findersee/RP2040-MQTT-Controller/README.md

# Controller
<p>RP2040 MQTT Controller for DIN Rail</p>
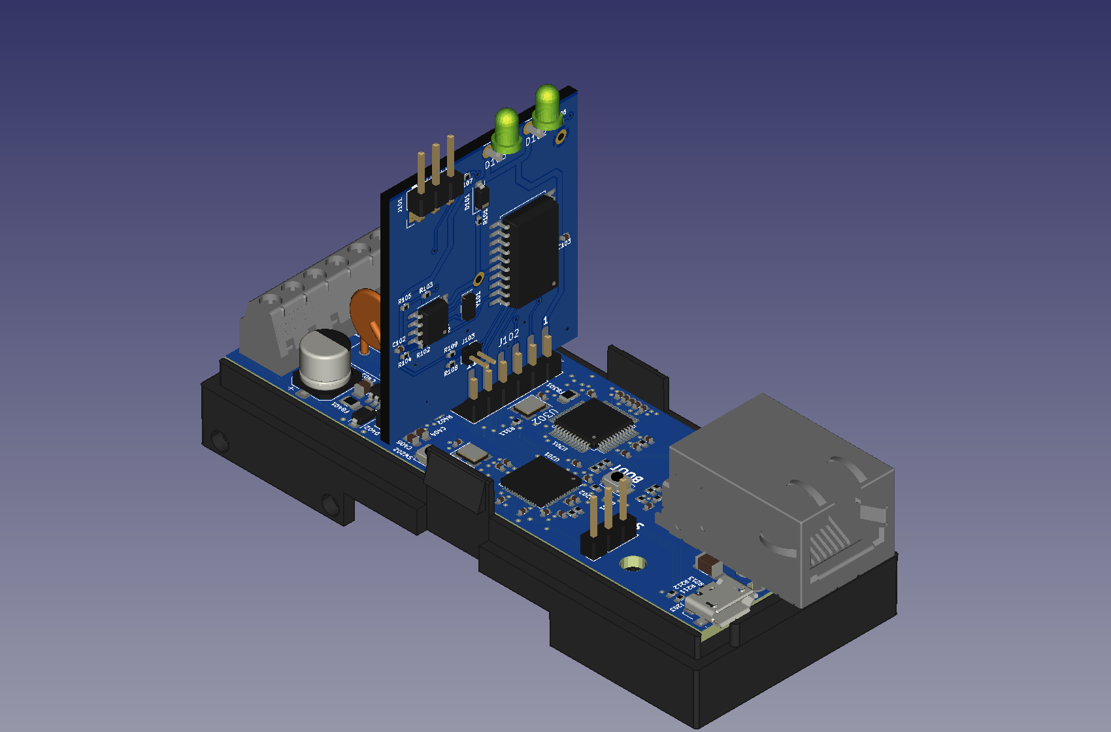
[picture p1: Open.png]


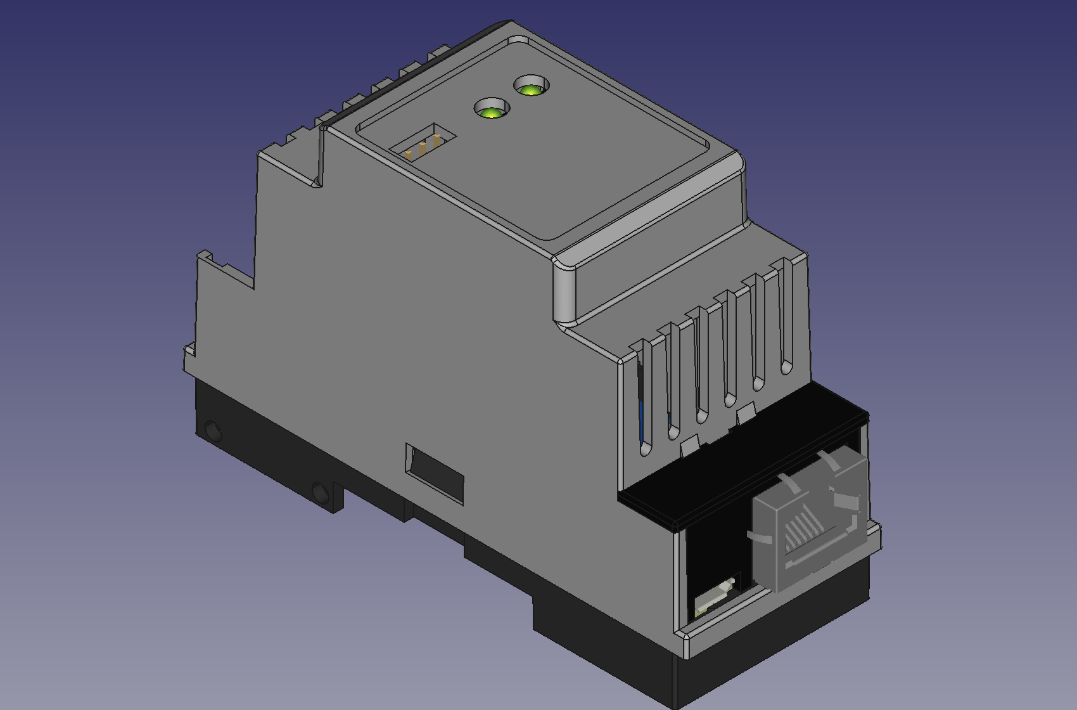
[picture p2: Closed.png]
