findersee/RP2040-MQTT-Controller/Electronics/README.md

# Controller
<p>RP2040 Ethernet board</p>
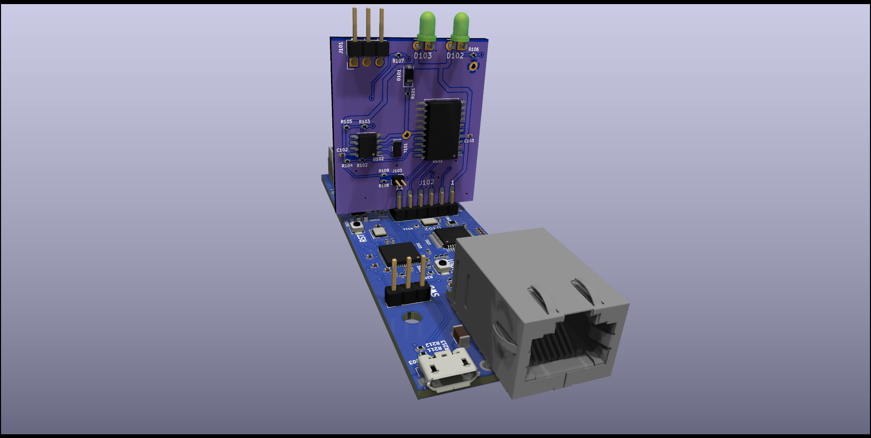
[picture p3: Electronics/Combined.png]
