findersee/RP2040-MQTT-Controller/Electronics/Controller/README.md

# Controller
<p>RP2040 Ethernet board</p>
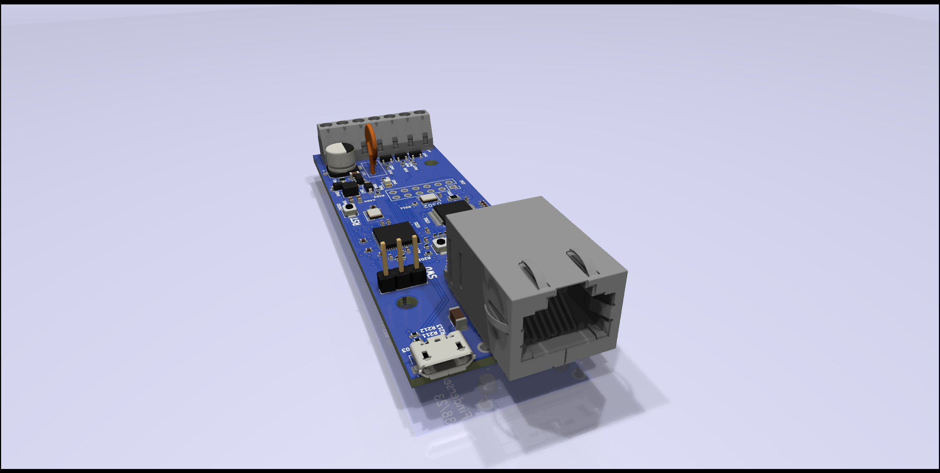
[picture p4: Electronics/Controller/Board.png]
