findersee/RP2040-MQTT-Controller/Electronics/3D/RTC_Module.step

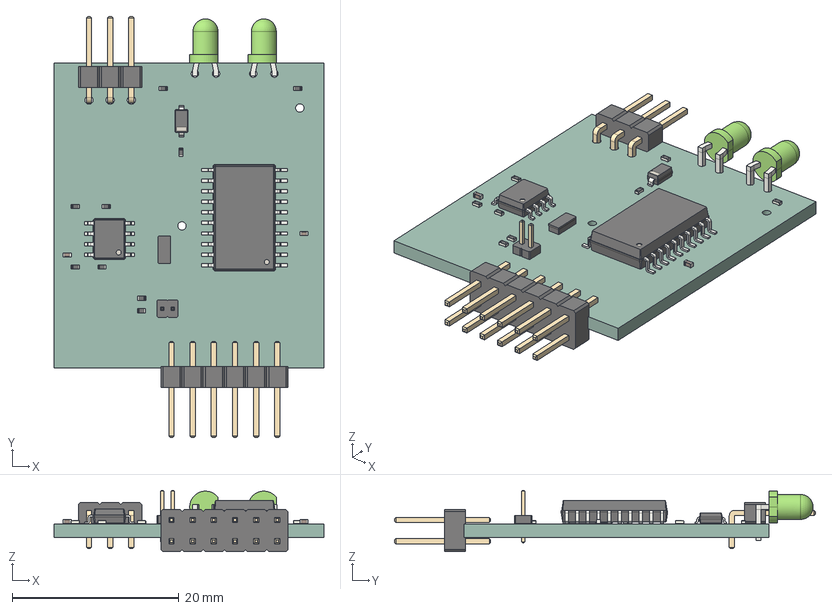
[picture p5: CAD file, 2023-09-16]
Electronics/3D/RTC_Module.step
32.4 x 50.5 x 7.37 mm
RTC_Module PCB
