findersee/RP2040-MQTT-Controller/Electronics/Controller/Controller.pdf

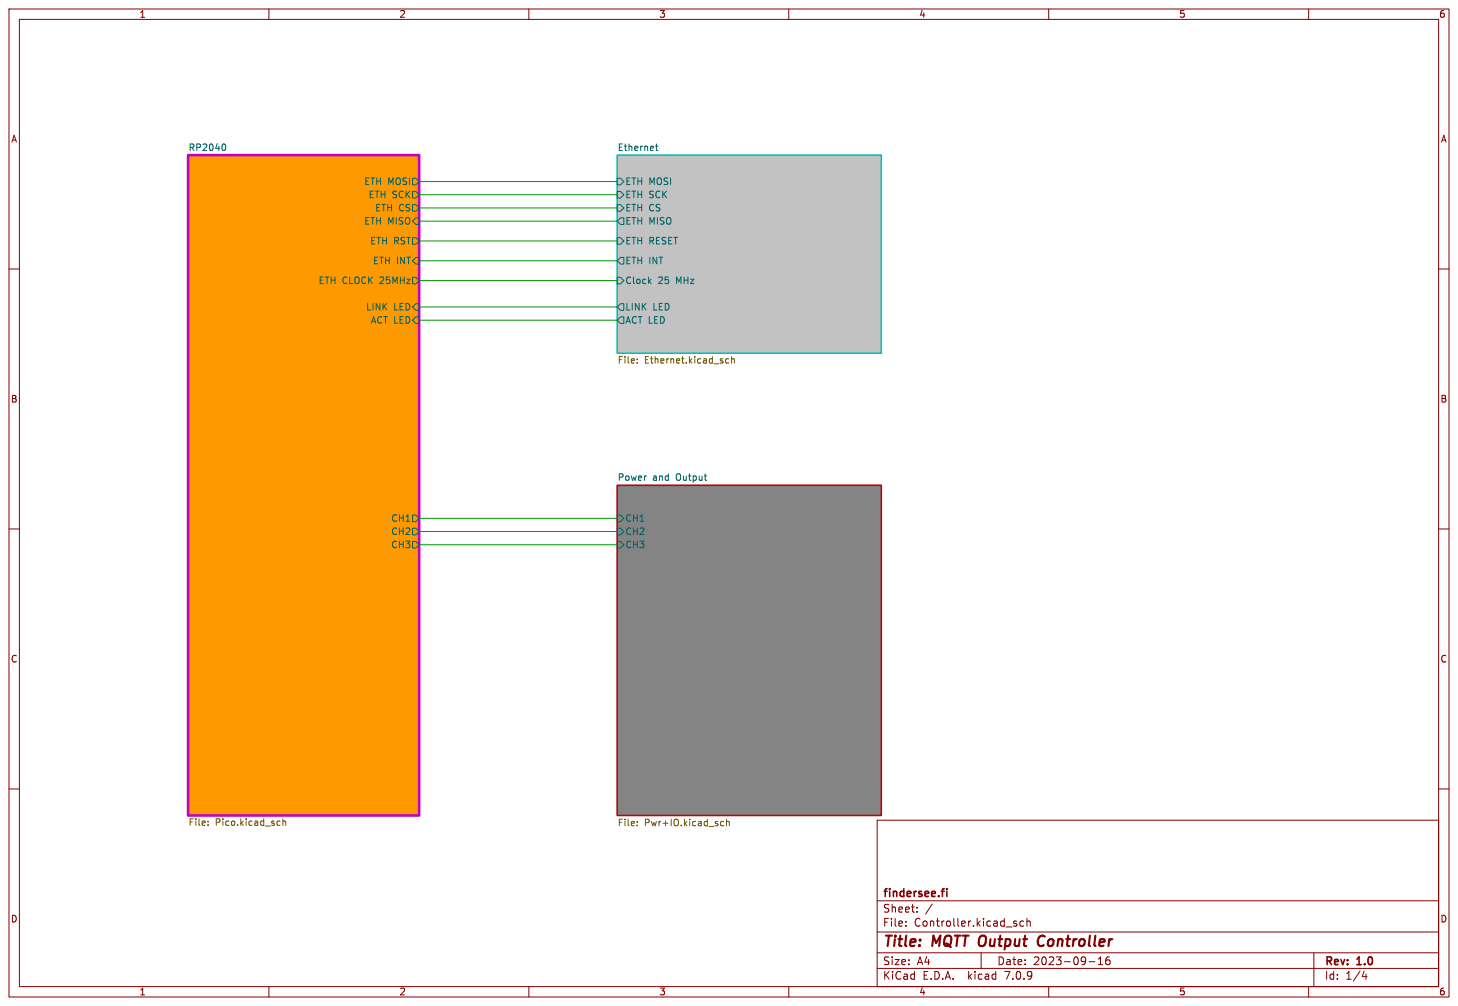
[picture p6: page 1]

Id: 1/4 Title: MQTT Output Controller File: Controller.kicad_sch Sheet: / findersee.fi CH3 CH2 CH1 Power and Output File: Pwr+IO.kicad_sch CH1 CH2 CH3 ETH MOSI ETH SCK

ETH MOSI Clock 25 MHz LINK LED
ETH SCK
ETH CS
ETH INT ETH RESET ETH MISO

ETH RST ETH INT ETH CLOCK 25MHz ACT LED

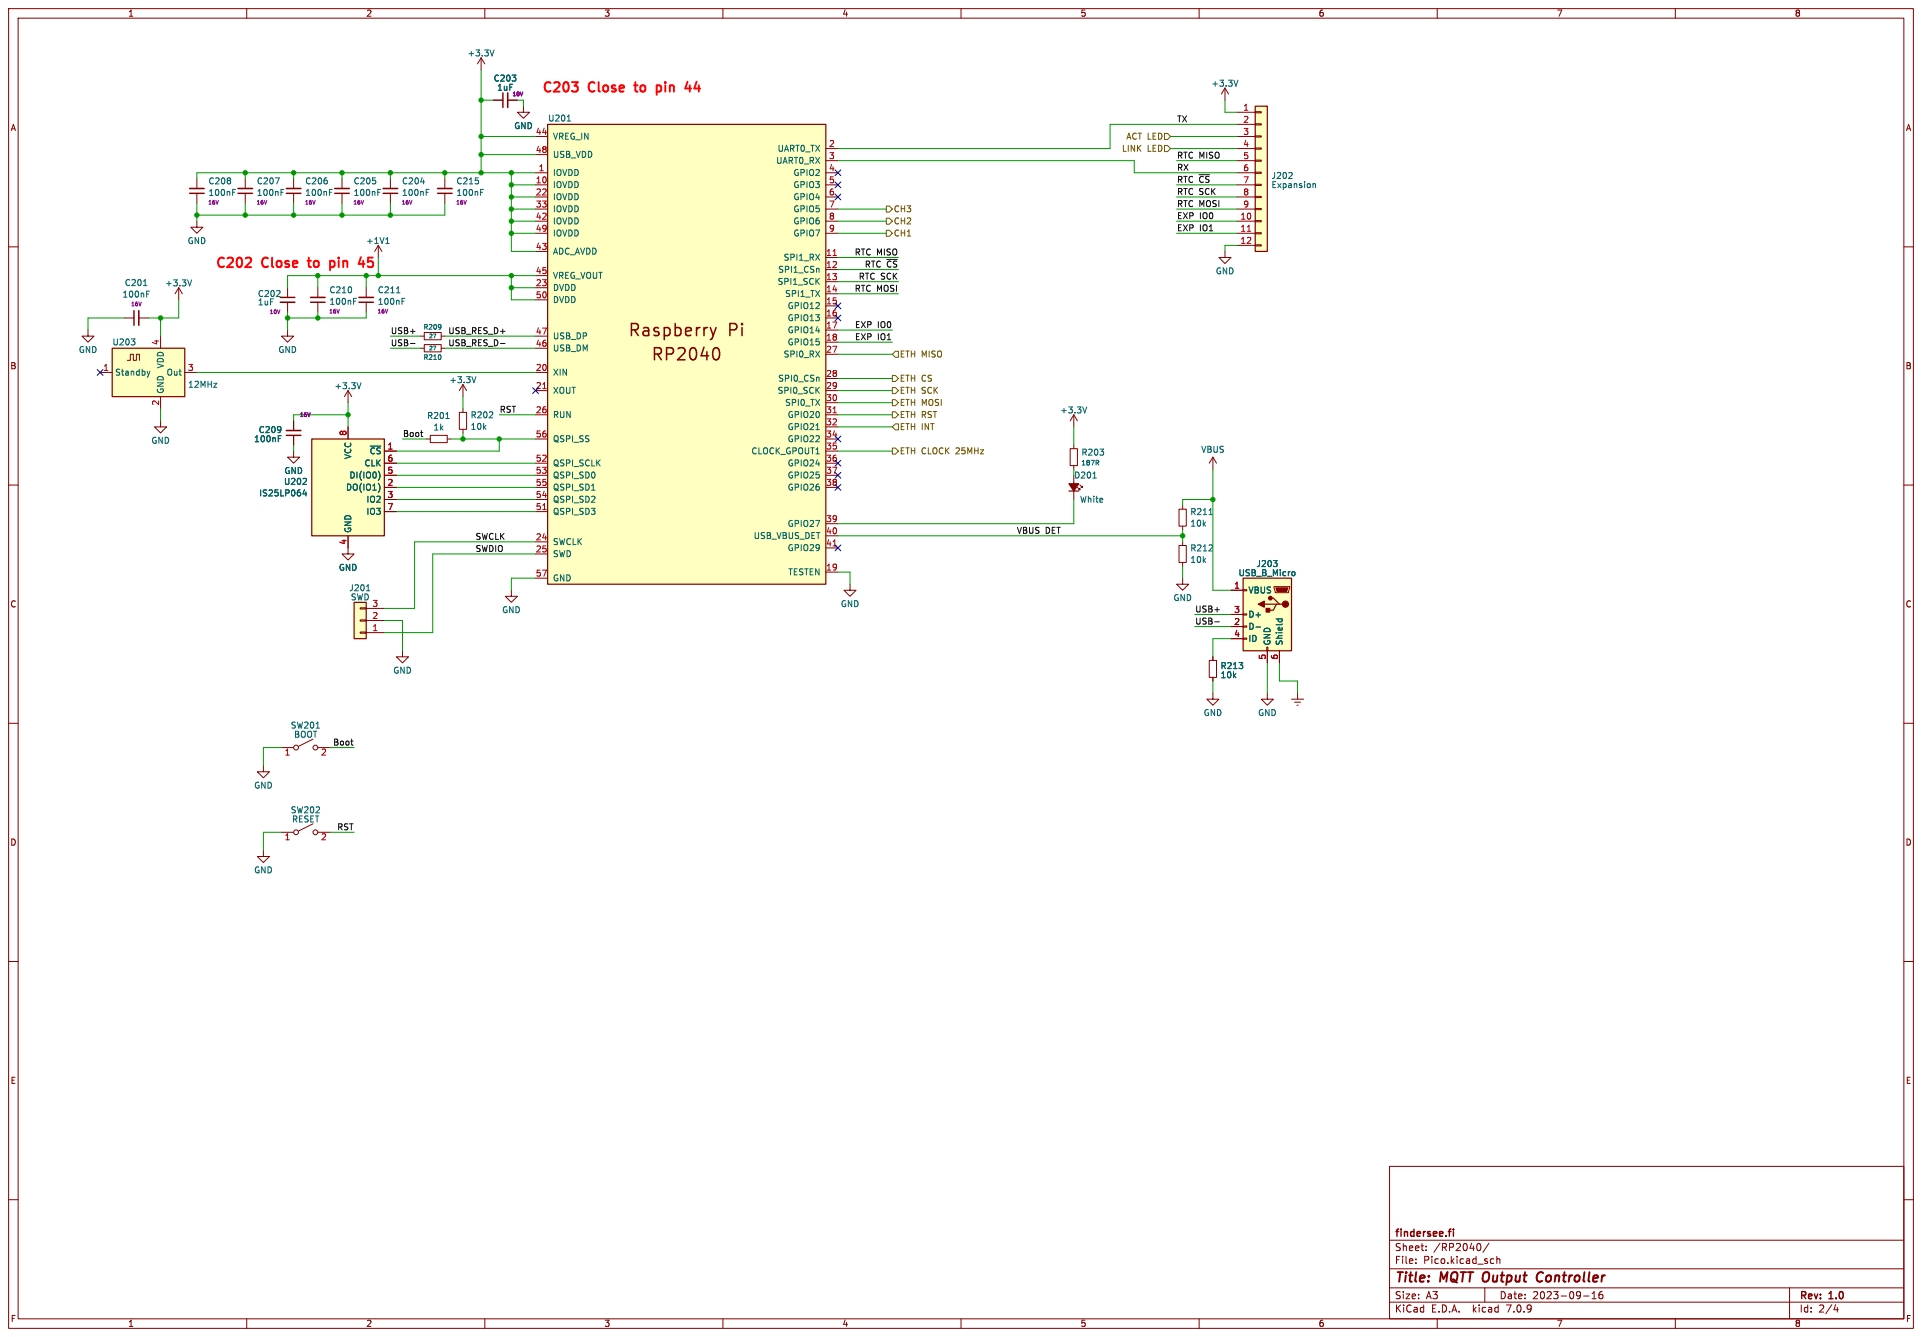
[picture p7: page 2]

EXP IO0 C203 Close to pin 44

ACT LED
ETH MOSI ETH INT ETH CLOCK 25MHz ETH RST CH1 CH2 CH3 ETH CS

EXP IO1 RTC ~{CS} RTC MISO

RTC MOSI RTC SCK

RTC ~{CS} RTC MISO

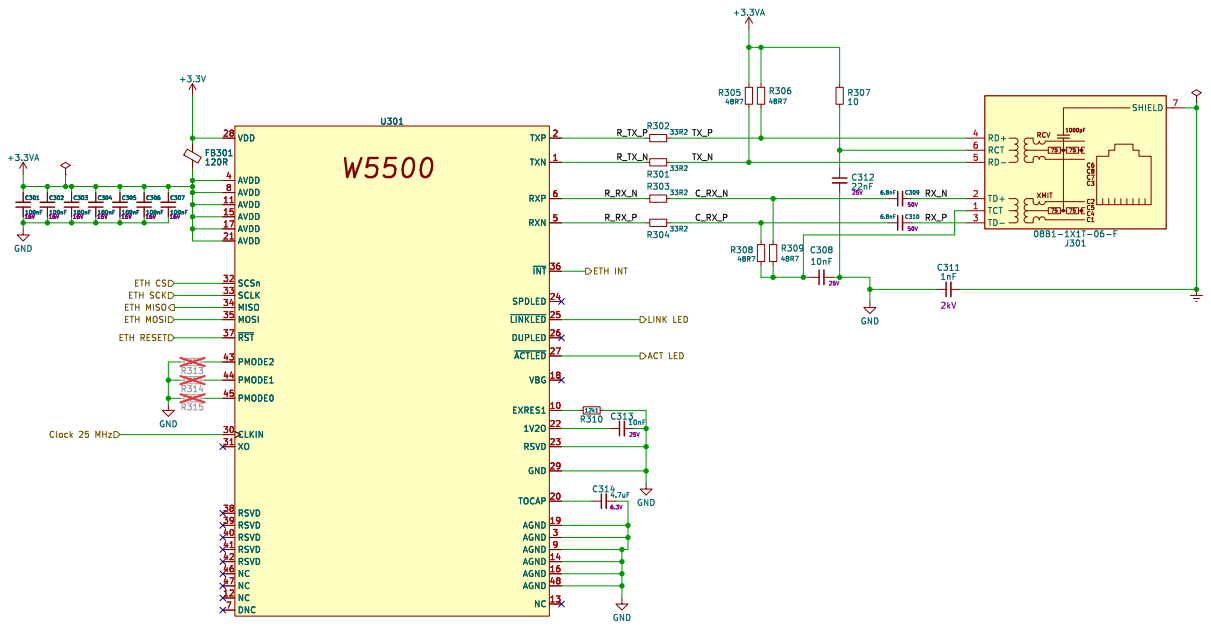
[picture p8: page 3]

ETH CS
ETH MOSI ETH SCK

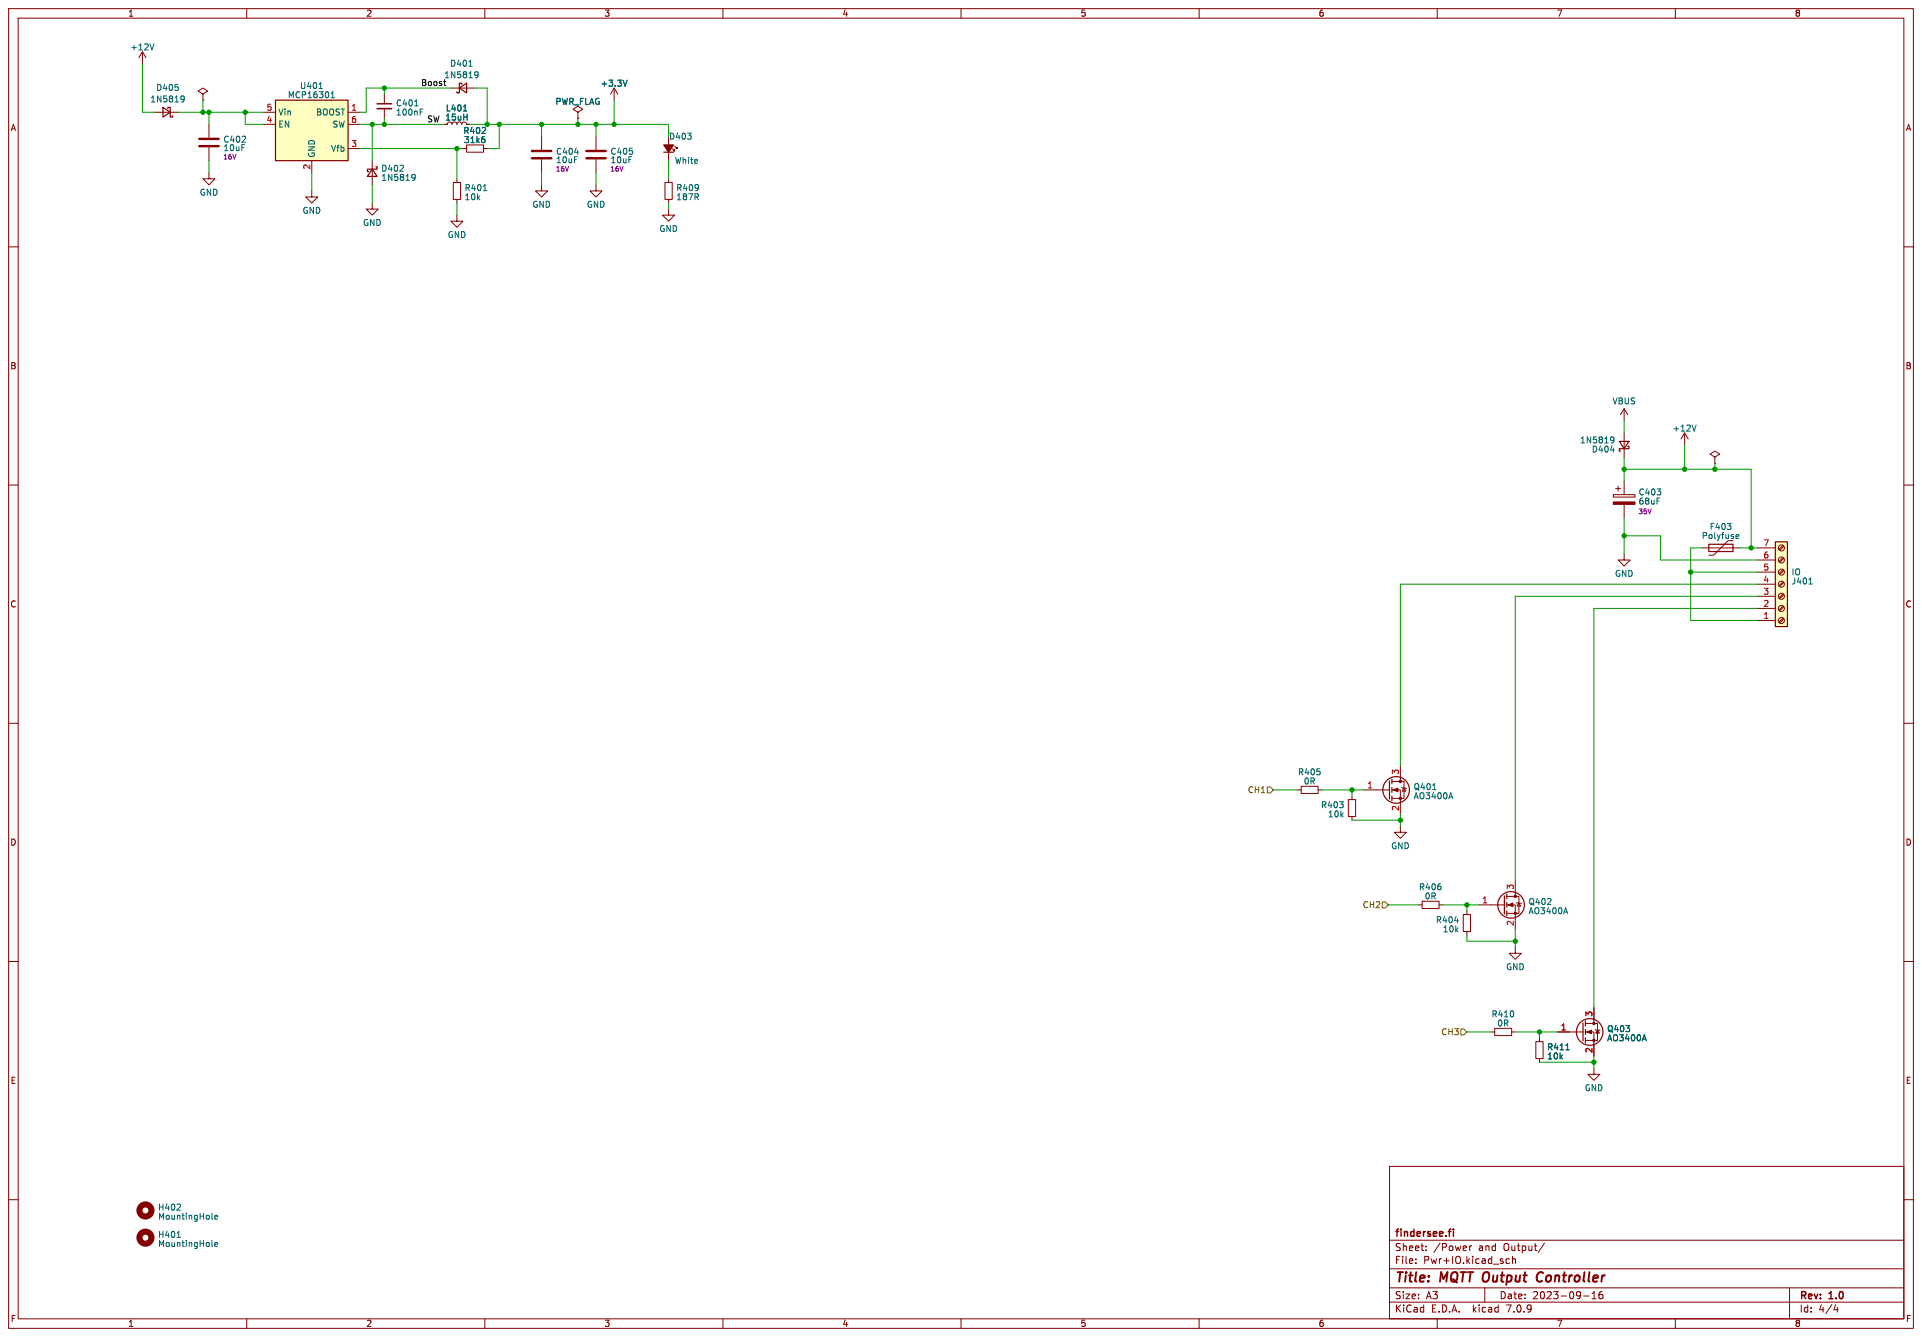
[picture p9: page 4]

2 Vfb 3 EN 4 Vin 5 SW 6 U401 MCP16301 C402
