findersee/RP2040-MQTT-Controller/Electronics/RTC_Module/RTC_Module.pdf

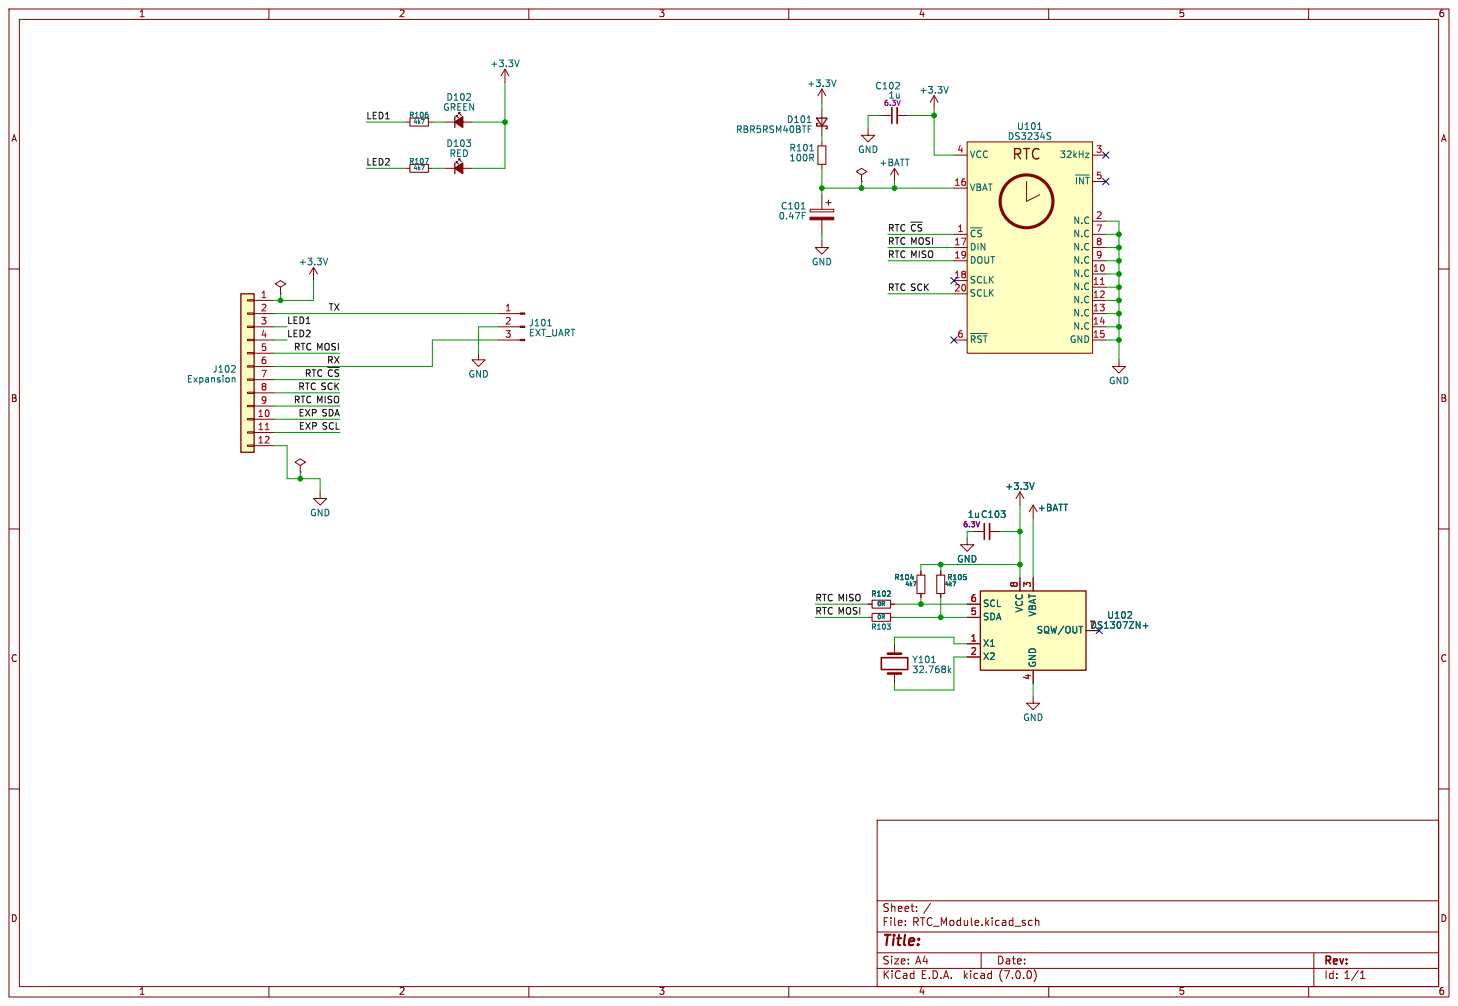
[picture p10: page 1]

RTC ~{CS} RTC MOSI RTC MISO
GND

RTC ~{CS} LED1 EXP SDA
LED2 RTC MOSI RTC MISO

Id: 1/1 Title: File: RTC_Module.kicad_sch Sheet: /
