findersee/RP2040-MQTT-Controller/Electronics/Controller/Controller.kicad_pcb

## KiCad design Electronics/Controller/Controller.kicad_pcb (2024-02-19)

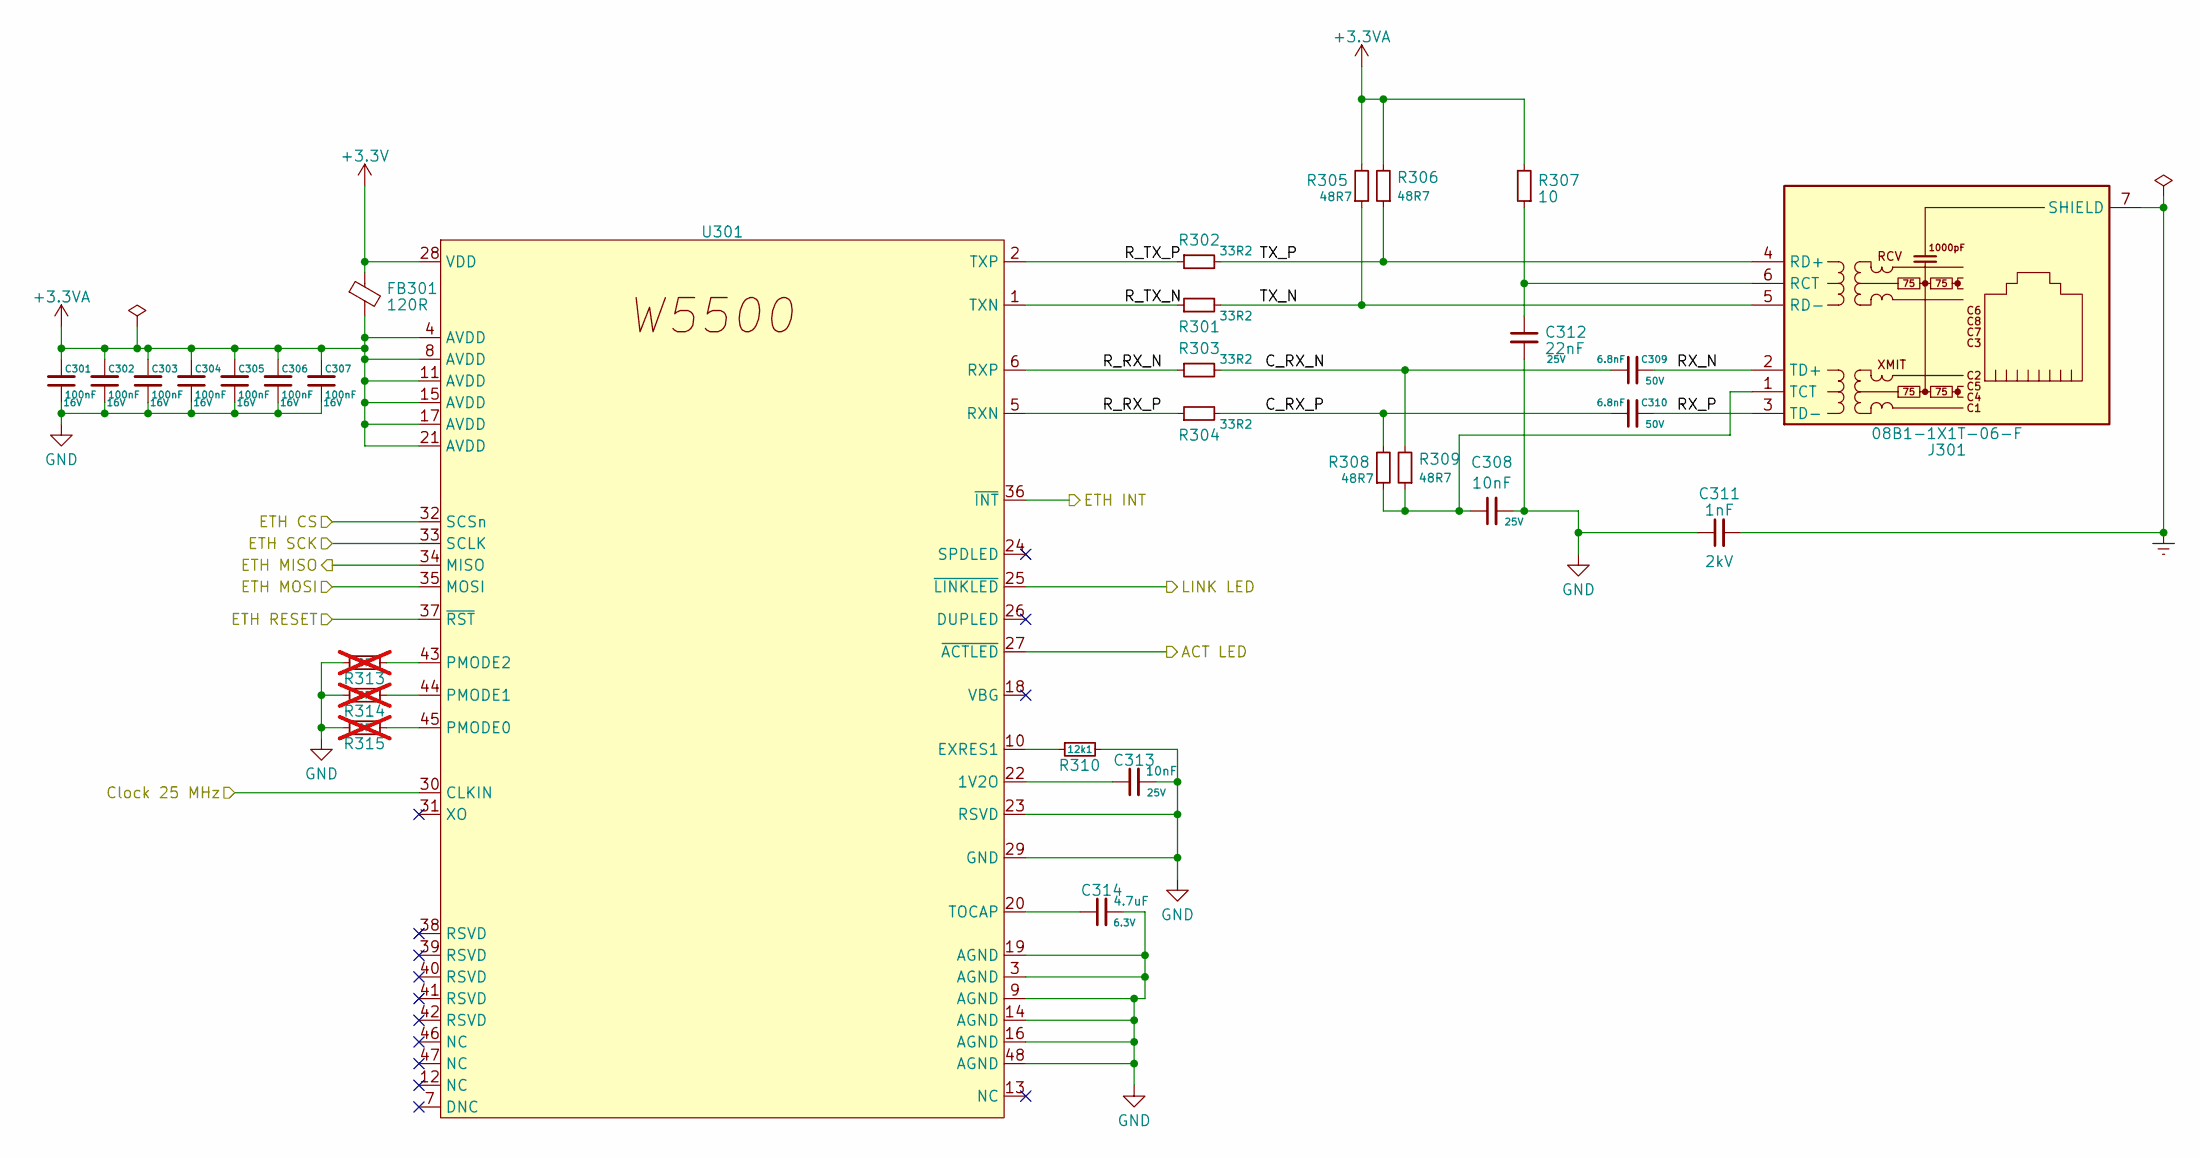
[picture p11: schematic Ethernet.kicad_sch, MQTT Output Controller]

Parts:
C301, C302, C303, C304, C305, C306, C307: 100nF; C_0402_1005Metric; Voltage 16V
C308, C313: 10nF; C_0402_1005Metric; Voltage 25V
C309, C310: 6.8nF; C_0402_1005Metric; Voltage 50V
C311: 1nF; C_1206_3216Metric; Voltage 2kV
C312: 22nF; C_0402_1005Metric; Voltage 25V
C314: 4.7uF; C_0402_1005Metric; Voltage 6.3V
FB301: 120R; R_0805_2012Metric
J301: 08B1-1X1T-06-F
R301, R302, R303, R304: 33R2; R_0402_1005Metric
R305, R306, R308, R309: 48R7; R_0402_1005Metric
R307: 10; R_0402_1005Metric
R310: 12k1; R_0402_1005Metric
R313, R314, R315: 0R; R_0402_1005Metric; not fitted
U301: W5500; TQFP-48_7x7mm_P0.5mm

Connections:
+3.3V: FB301.1, U301.28 (VDD); also elsewhere on the board
+3.3VA: C301.2, C302.2, C303.2, C304.2, C305.2, C306.2, C307.2, FB301.2, R305.2, R306.2, R307.2, U301.4 (AVDD), U301.8 (AVDD), U301.11 (AVDD), U301.15 (AVDD), U301.17 (AVDD), U301.21 (AVDD)
/Ethernet/ACT LED: U301.27 (~ACTLED); also elsewhere on the board
/Ethernet/C_RX_N: C309.1, R303.2, R309.2
/Ethernet/C_RX_P: C310.1, R304.2, R308.2
/Ethernet/Clock 25 MHz: U301.30 (CLKIN); also elsewhere on the board
/Ethernet/ETH CS: U301.32 (SCSn); also elsewhere on the board
/Ethernet/ETH INT: U301.36 (~INT); also elsewhere on the board
/Ethernet/ETH MISO: U301.34 (MISO); also elsewhere on the board
/Ethernet/ETH MOSI: U301.35 (MOSI); also elsewhere on the board
/Ethernet/ETH RESET: U301.37 (~RST); also elsewhere on the board
/Ethernet/ETH SCK: U301.33 (SCLK); also elsewhere on the board
/Ethernet/LINK LED: U301.25 (~LINKLED); also elsewhere on the board
/Ethernet/RX_N: C309.2, J301.2 (TD+)
/Ethernet/RX_P: C310.2, J301.3 (TD-)
/Ethernet/R_RX_N: R303.1, U301.6 (RXP)
/Ethernet/R_RX_P: R304.1, U301.5 (RXN)
/Ethernet/R_TX_N: R301.1, U301.1 (TXN)
/Ethernet/R_TX_P: R302.1, U301.2 (TXP)
/Ethernet/TX_N: J301.5 (RD-), R301.2, R305.1
/Ethernet/TX_P: J301.4 (RD+), R302.2, R306.1
Earth: C311.2, J301.7 (SHIELD); also elsewhere on the board
GND: C301.1, C302.1, C303.1, C304.1, C305.1, C306.1, C307.1, C308.2, C311.1, C312.2, C313.2, C314.2, R310.2, R313.1, R314.1, R315.1, U301.3 (AGND), U301.9 (AGND), U301.14 (AGND), U301.16 (AGND), U301.19 (AGND), U301.23 (RSVD), U301.29 (GND), U301.48 (AGND); also elsewhere on the board
unnamed: C312.1, J301.6 (RCT), R307.1
unnamed: C308.1, J301.1 (TCT), R308.1, R309.1
unnamed: C313.1, U301.22 (1V2O)
unnamed: R310.1, U301.10 (EXRES1)
unnamed: R315.2, U301.45 (PMODE0)
unnamed: R314.2, U301.44 (PMODE1)
unnamed: R313.2, U301.43 (PMODE2)
unnamed: C314.1, U301.20 (TOCAP)

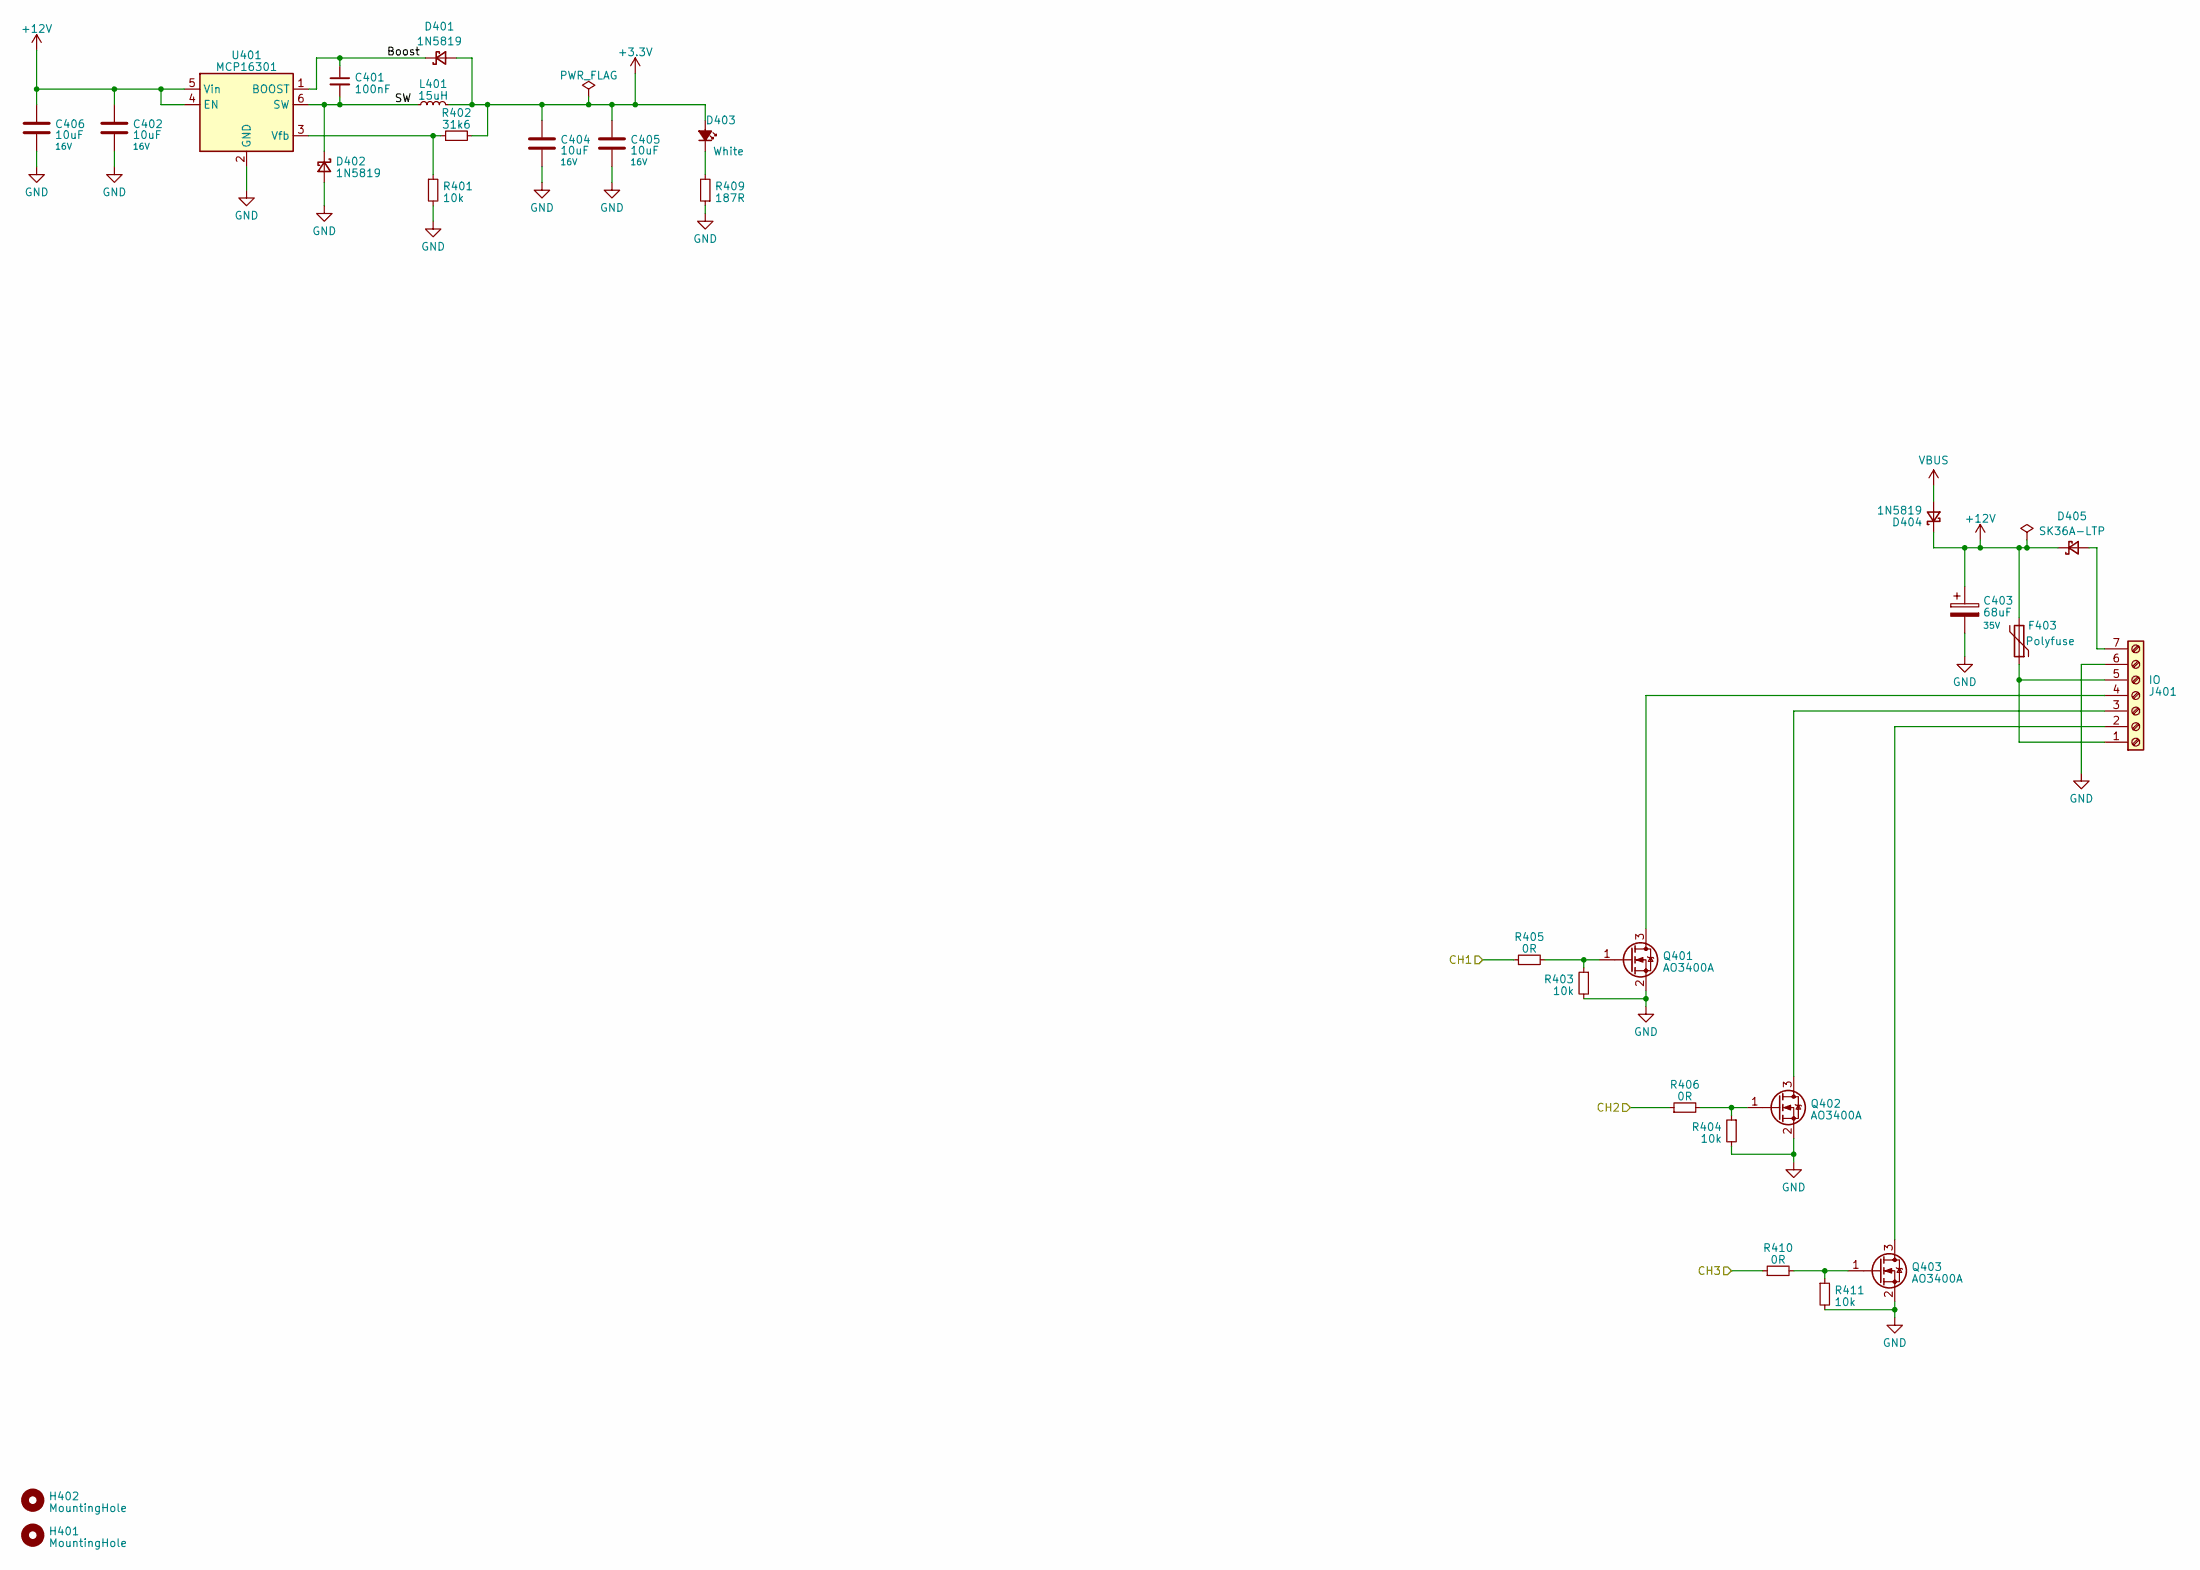
[picture p12: schematic Pwr+IO.kicad_sch, MQTT Output Controller]

Parts:
C401: 100nF; C_0402_1005Metric
C402, C404, C405, C406: 10uF; C_0805_2012Metric; Voltage 16V
C403: 68uF; CP_Elec_6.3x5.8; Voltage 35V
D401, D402, D404: 1N5819; D_SOD-123
D403: White; LED_0603_1608Metric
D405: SK36A-LTP; D_SMA
F403: Polyfuse; Fuse_BelFuse_0ZRE0005FF_L8.3mm_W3.8mm
H401, H402: MountingHole; MountingHole_2.5mm
J401: IO; Terminal-Block-01x07_P3.81
L401: 15uH; L_Coilcraft_LPS3010
Q401, Q402, Q403: AO3400A; SOT-23
R401, R403, R404, R411: 10k; R_0402_1005Metric
R402: 31k6; R_0402_1005Metric
R405, R406, R410: 0R; R_0402_1005Metric
R409: 187R; R_0402_1005Metric
U401: MCP16301; SOT-23-6

Connections:
+3.3V: C404.1, C405.1, D401.2 (A), D403.2 (A), L401.2, R402.2; also elsewhere on the board
+12V: C402.1, C403.1, C406.1, D404.1 (K), D405.1 (K), F403.2, U401.4 (EN), U401.5 (Vin)
/Power and Output/Boost: C401.1, D401.1 (K), U401.1 (BOOST)
/Power and Output/CH1: R405.1; also elsewhere on the board
/Power and Output/CH2: R406.1; also elsewhere on the board
/Power and Output/CH3: R410.1; also elsewhere on the board
/Power and Output/SW: C401.2, D402.1 (K), L401.1, U401.6 (SW)
GND: C402.2, C403.2, C404.2, C405.2, C406.2, D402.2 (A), J401.6, Q401.2 (S), Q402.2 (S), Q403.2 (S), R401.2, R403.2, R404.2, R409.1, R411.2, U401.2 (GND); also elsewhere on the board
unnamed: D403.1 (K), R409.2
unnamed: D405.2 (A), J401.7
unnamed: F403.1, J401.1, J401.5
unnamed: J401.2, Q403.3 (D)
unnamed: J401.3, Q402.3 (D)
unnamed: J401.4, Q401.3 (D)
unnamed: Q401.1 (G), R403.1, R405.2
unnamed: Q402.1 (G), R404.1, R406.2
unnamed: Q403.1 (G), R410.2, R411.1
unnamed: R401.1, R402.1, U401.3 (Vfb)
VBUS: D404.2 (A); also elsewhere on the board

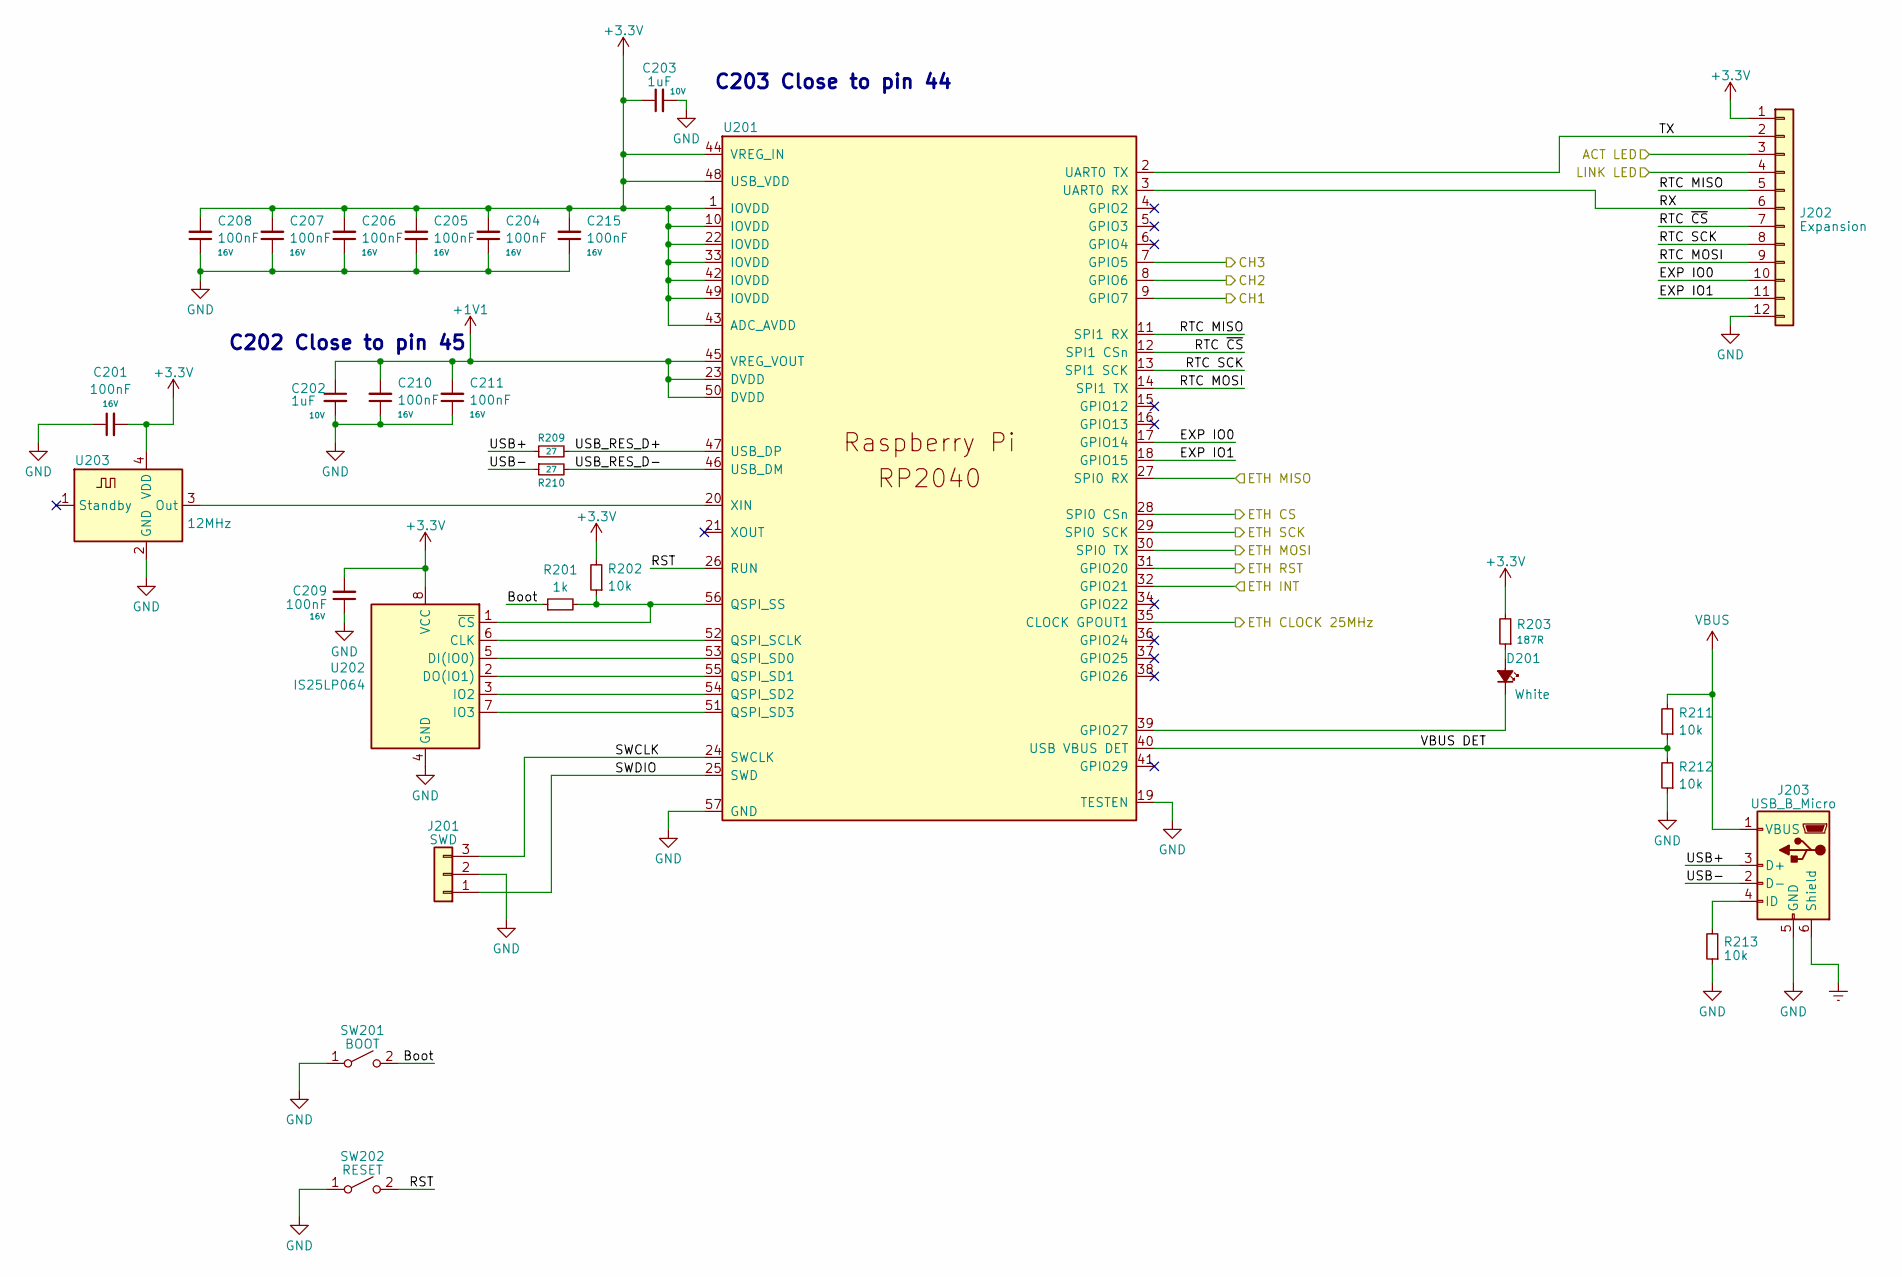
[picture p13: schematic Pico.kicad_sch, MQTT Output Controller]

Parts:
C201, C204, C205, C206, C207, C208, C209, C210, C211, C215: 100nF; C_0402_1005Metric; Voltage 16V
C202, C203: 1uF; C_0402_1005Metric; Voltage 10V
D201: White; LED_0603_1608Metric
J201: SWD; PinHeader_1x03_P2.54mm_Vertical
J202: Expansion; PinSocket_2x06_P2.54mm_Vertical
J203: USB_B_Micro; USB_Micro-B_Molex_47346-0001
R201: 1k; R_0402_1005Metric
R202, R211, R212, R213: 10k; R_0402_1005Metric
R203: 187R; R_0402_1005Metric
R209, R210: 27; R_0402_1005Metric
SW201: BOOT; SW_SPST_B3U-1000P
SW202: RESET; SW_SPST_B3U-1000P
U201: RP2040; RP2040-QFN-56
U202: IS25LP064; SOIC-8_5.23x5.23mm_P1.27mm
U203: 12MHz; Oscillator_SMD_SeikoEpson_SG8002CE-4Pin_3.2x2.5mm

Connections:
+1V1: C202.1, C210.2, C211.2, U201.23 (DVDD), U201.45 (VREG_VOUT), U201.50 (DVDD)
+3.3V: C201.2, C203.1, C204.2, C205.2, C206.2, C207.2, C208.2, C209.2, C215.2, J202.1, R202.2, R203.2, U201.1 (IOVDD), U201.10 (IOVDD), U201.22 (IOVDD), U201.33 (IOVDD), U201.42 (IOVDD), U201.43 (ADC_AVDD), U201.44 (VREG_IN), U201.48 (USB_VDD), U201.49 (IOVDD), U202.8 (VCC), U203.4 (VDD); also elsewhere on the board
/Ethernet/ACT LED: J202.3; also elsewhere on the board
/Ethernet/Clock 25 MHz: U201.35 (CLOCK GPOUT1); also elsewhere on the board
/Ethernet/ETH CS: U201.28 (SPI0 CSn); also elsewhere on the board
/Ethernet/ETH INT: U201.32 (GPIO21); also elsewhere on the board
/Ethernet/ETH MISO: U201.27 (SPI0 RX); also elsewhere on the board
/Ethernet/ETH MOSI: U201.30 (SPI0 TX); also elsewhere on the board
/Ethernet/ETH RESET: U201.31 (GPIO20); also elsewhere on the board
/Ethernet/ETH SCK: U201.29 (SPI0 SCK); also elsewhere on the board
/Ethernet/LINK LED: J202.4; also elsewhere on the board
/Power and Output/CH1: U201.9 (GPIO7); also elsewhere on the board
/Power and Output/CH2: U201.8 (GPIO6); also elsewhere on the board
/Power and Output/CH3: U201.7 (GPIO5); also elsewhere on the board
/RP2040/Boot: R201.1, SW201.2 (B)
/RP2040/EXP IO0: J202.10, U201.17 (GPIO14)
/RP2040/EXP IO1: J202.11, U201.18 (GPIO15)
/RP2040/RST: SW202.2 (B), U201.26 (RUN)
/RP2040/RTC MISO: J202.5, U201.11 (SPI1 RX)
/RP2040/RTC MOSI: J202.9, U201.14 (SPI1 TX)
/RP2040/RTC SCK: J202.8, U201.13 (SPI1 SCK)
/RP2040/RTC ~CS: J202.7, U201.12 (SPI1 CSn)
/RP2040/RX: J202.6, U201.3 (UART0 RX)
/RP2040/SWCLK: J201.3, U201.24 (SWCLK)
/RP2040/SWDIO: J201.1, U201.25 (SWD)
/RP2040/TX: J202.2, U201.2 (UART0 TX)
/RP2040/USB+: J203.3 (D+), R209.1
/RP2040/USB-: J203.2 (D-), R210.1
/RP2040/USB_RES_D+: R209.2, U201.47 (USB_DP)
/RP2040/USB_RES_D-: R210.2, U201.46 (USB_DM)
/RP2040/VBUS DET: R211.1, R212.2, U201.40 (USB VBUS DET)
Earth: J203.6 (Shield); also elsewhere on the board
GND: C201.1, C202.2, C203.2, C204.1, C205.1, C206.1, C207.1, C208.1, C209.1, C210.1, C211.1, C215.1, J201.2, J202.12, J203.5 (GND), R212.1, R213.1, SW201.1 (A), SW202.1 (A), U201.19 (TESTEN), U201.57 (GND), U202.4 (GND), U203.2 (GND); also elsewhere on the board
unnamed: D201.2 (A), R203.1
unnamed: D201.1 (K), U201.39 (GPIO27)
unnamed: J203.4 (ID), R213.2
unnamed: U201.52 (QSPI_SCLK), U202.6 (CLK)
unnamed: U201.53 (QSPI_SD0), U202.5 (DI(IO0))
unnamed: U201.55 (QSPI_SD1), U202.2 (DO(IO1))
unnamed: U201.54 (QSPI_SD2), U202.3 (IO2)
unnamed: U201.51 (QSPI_SD3), U202.7 (IO3)
unnamed: R201.2, R202.1, U201.56 (QSPI_SS), U202.1 (~CS)
unnamed: U201.20 (XIN), U203.3 (Out)
VBUS: J203.1 (VBUS), R211.2; also elsewhere on the board

Notes on the sheet:
C202 Close to pin 45
C203 Close to pin 44

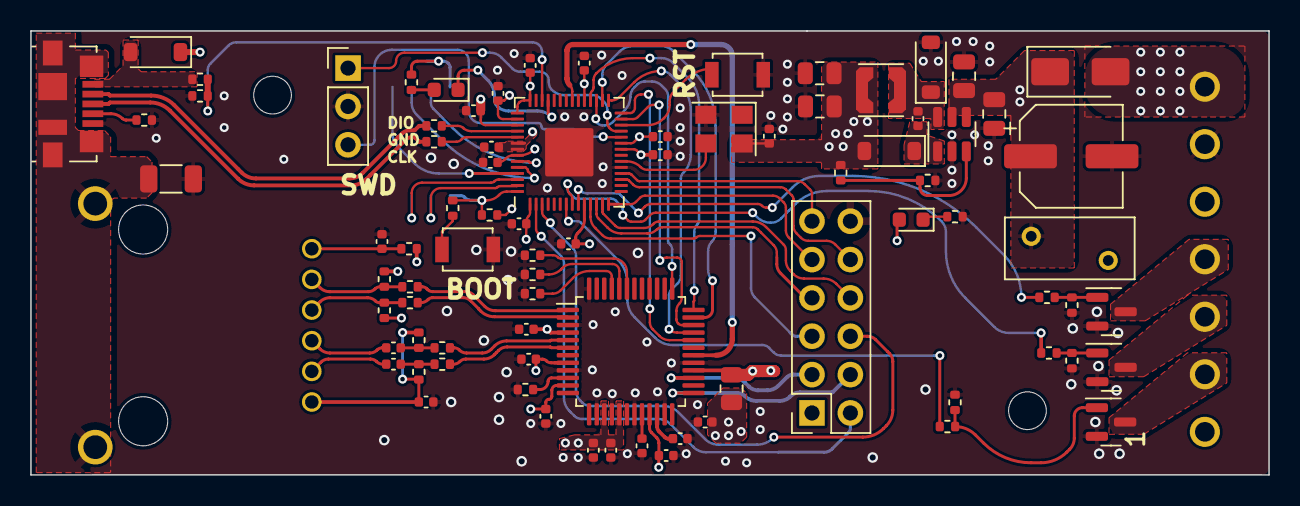
[picture p14: board Controller.kicad_pcb from above]

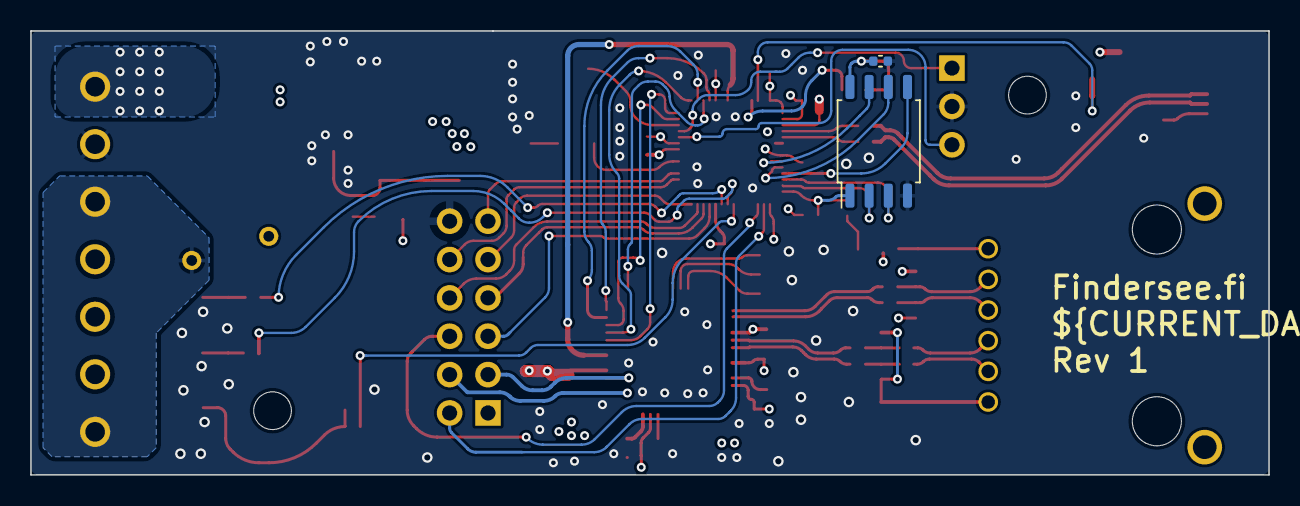
[picture p15: board Controller.kicad_pcb from below]

Board: 4 copper layers, 82.0 x 29.4 mm, 88 parts (2 on the bottom side), 76 nets.
