findersee/RP2040-MQTT-Controller/Electronics/RTC_Module/RTC_Module.kicad_pcb

## KiCad design Electronics/RTC_Module/RTC_Module.kicad_pcb (2023-11-02)

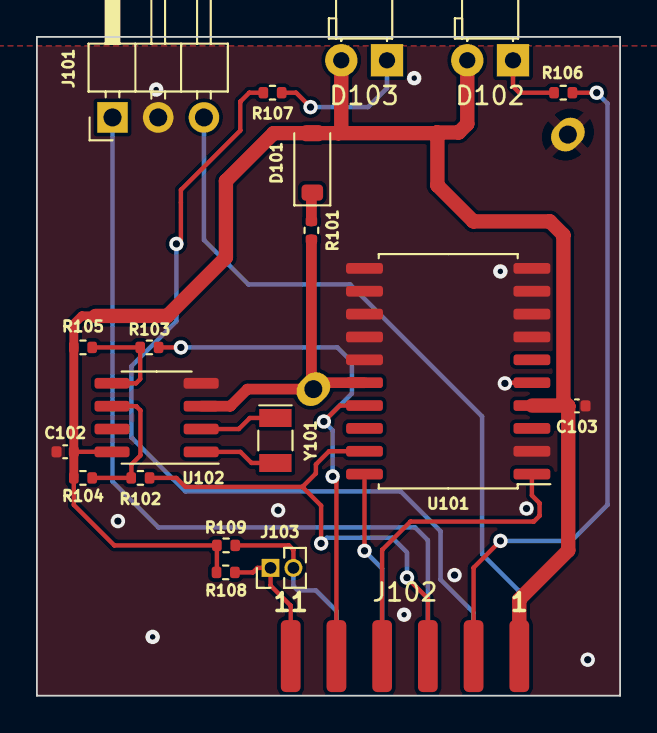
[picture p16: board RTC_Module.kicad_pcb from above]

Board: 2 copper layers, 32.4 x 36.6 mm, 21 parts (1 on the bottom side), 20 nets.

Parts:
C101: 0.47F; EECS5R5474
C102, C103: 1u; C_0402_1005Metric
D101: 1N5819; D_SOD-123
D102: GREEN; LED_D3.0mm_Horizontal_O1.27mm_Z2.0mm
D103: RED; LED_D3.0mm_Horizontal_O1.27mm_Z2.0mm
J101: EXT_UART; PinHeader_1x03_P2.54mm_Horizontal
J102: Expansion; 02x06_SMD_2.54mm
J103: EXP I^{2}C; PinHeader_1x02_P1.27mm_Vertical
R101: 100R; R_0402_1005Metric
R102, R103: 0R; R_0402_1005Metric
R104, R105, R106, R107, R108, R109: 4k7; R_0402_1005Metric
U101: DS3234S; SOIC-20W_7.5x12.8mm_P1.27mm
U102: DS1307ZN+; SOIC-8_3.9x4.9mm_P1.27mm
Y101: 32.768k; Crystal_SMD_MicroCrystal_CC7V-T1A-2Pin_3.2x1.5mm

Connections:
+3.3V: C102.2, C103.2, D101.2 (A), D102.2 (A), D103.2 (A), J102.1, R104.1, R105.1, R108.2, R109.1, U101.4 (VCC), U102.8 (VCC)
+BATT: C101.1, R101.2, U101.16 (VBAT), U102.3 (VBAT)
/IO 1: J102.10, J103.2, R108.1, U101.5 (~INT)
/IO 2: J102.11, J103.1, R109.2
/LED1: J102.3, R106.1
/LED2: J102.4, R107.1
/RTC MISO: J102.5, R102.1, U101.19 (DOUT)
/RTC MOSI: J102.9, R103.1, U101.17 (DIN)
/RTC SCK: J102.8, U101.20 (SCLK)
/RTC ~CS: J102.7, U101.1 (~CS)
/RX: J101.1, J102.6
/TX: J101.3, J102.2
GND: C101.2, C102.1, C103.1, J101.2, J102.12, U101.2 (N.C), U101.7 (N.C), U101.8 (N.C), U101.9 (N.C), U101.10 (N.C), U101.11 (N.C), U101.12 (N.C), U101.13 (N.C), U101.14 (N.C), U101.15 (GND), U102.4 (GND)
unnamed: D101.1 (K), R101.1
unnamed: D102.1 (K), R106.2
unnamed: D103.1 (K), R107.2
unnamed: R102.2, R104.2, U102.6 (SCL)
unnamed: R103.2, R105.2, U102.5 (SDA)
unnamed: U102.1 (X1), Y101.2
unnamed: U102.2 (X2), Y101.1
