findersee/RP2040-MQTT-Controller/(commit log)

2023-09-15 Electronics Commit
    [Ethernet.kicad_sch, Pico-MQTT-Controller.kicad_pcb, Pico-MQTT-Controller.kicad_sch, Pico.kicad_sch, Pwr+IO.kicad_sch]
2023-09-16 Added RTC Module And Step models for PCBs
    [Controller.kicad_pcb, Controller.kicad_sch, Ethernet.kicad_sch, Pico-MQTT-Controller.kicad_pcb, Pico-MQTT-Controller.kicad_sch, Pico.kicad_sch, Pwr+IO.kicad_sch, RTC_Module.kicad_pcb]
2023-09-16 PDF Update
    [Controller.kicad_sch, Ethernet.kicad_sch, Pico.kicad_sch, Pwr+IO.kicad_sch]
2023-09-16 Removed Production folders
    [bom.csv, designators.csv, positions.csv]
2023-09-17 Manufacturing Commit
    [Controller.kicad_pcb, Ethernet.kicad_sch, Pico.kicad_sch, RTC_Module.kicad_pcb]
2023-09-17 Added Readme images
    [Controller.kicad_pcb, RTC_Module.kicad_pcb]
2023-09-19 Manufacturing commit 2
    [Controller.kicad_pcb, Pico.kicad_sch, Pwr+IO.kicad_sch]
2023-09-25 Created DS3234 RTC IC Driver
2023-09-25 Removed not used pico-extras submodule
2023-09-26 Improved DS3234 Driver Added microjson to the project
2023-09-27 Created Uptime task Created first prototype of json messages
2023-10-02 Creating settings logic for relay array
2023-10-02 Added Temperature info to the uptime MQTT publish
2023-10-14 Pin goof fix
    [Controller.kicad_pcb, Pico.kicad_sch, Pwr+IO.kicad_sch, RTC_Module.kicad_pcb, RTC_Module.kicad_sch]
2023-10-17 DS3234_Driver Fixes Added watch dog reset
    [RTC_Module.kicad_sch]
2023-11-02 Added library Fixed layout bugs Software improvements
    [Controller.kicad_pcb, Ethernet.kicad_sch, Pico.kicad_sch, Pwr+IO.kicad_sch, RTC_Module.kicad_pcb, RTC_Module.kicad_sch]
2023-11-23 Changed Topic to use device serial
2024-01-11 Schematic and Layout update
    [Controller.kicad_pcb, Ethernet.kicad_sch, Pwr+IO.kicad_sch]
